diembv/ESP32C6-Outdoor-Tracker/hardware/case/stl/tracker_full_print_plate.stl

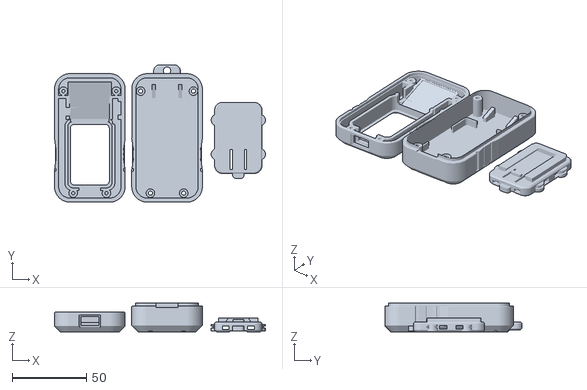
[picture p2: CAD file, 2026-11-12]
hardware/case/stl/tracker_full_print_plate.stl
142.1 x 92.5 x 19.3
