diembv/ESP32C6-Outdoor-Tracker/hardware/case/stl/tracker_bottom_shell.stl

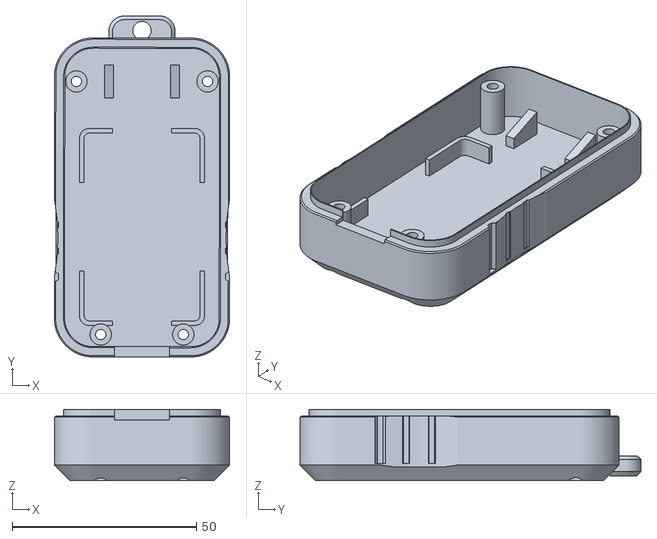
[picture p3: CAD file, 2026-11-12]
hardware/case/stl/tracker_bottom_shell.stl
47.6 x 92.5 x 19.3
