diembv/ESP32C6-Outdoor-Tracker/hardware/case/stl/tracker_bike_mount_base.stl

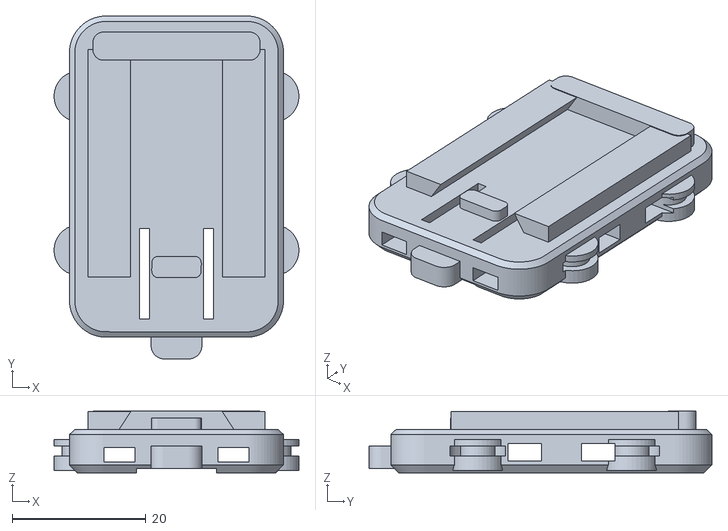
[picture p4: CAD file, 2026-11-12]
hardware/case/stl/tracker_bike_mount_base.stl
36.6 x 51.2 x 9.25
