diembv/ESP32C6-Outdoor-Tracker/hardware/case/stl/tracker_top_cover.stl

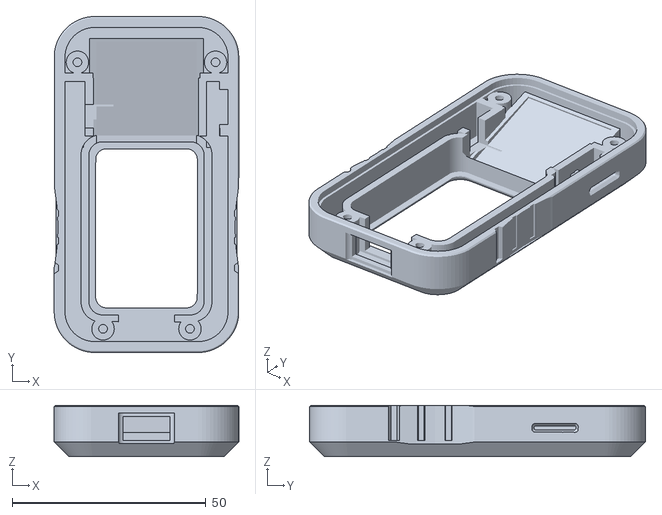
[picture p5: CAD file, 2026-11-12]
hardware/case/stl/tracker_top_cover.stl
47.6 x 86.6 x 13.2
