diembv/ESP32C6-Outdoor-Tracker/(commit log)

2026-09-27 feat: Bring-up GPS, I2C BMP580/IMU, AMOLED display & project setup
2026-09-29 fix SD card for logging
    [main.cpp, sd_logger.cpp, ui_dashboard.cpp]
2026-09-29 add time, fix logging and sd card
    [main.cpp, sd_logger.cpp, sd_logger.h, ui_dashboard.cpp, ui_dashboard.h]
2026-10-01 fix logging, micro SD
    [main.cpp, sd_logger.cpp, sd_logger.h, ui_dashboard.cpp]
2026-10-05 add tool convert gpx and fix
    [main.cpp, sd_logger.cpp, sd_logger.h, ui_dashboard.h]
2026-11-12 chore(hardware): setup standard 3d case directory structure and gitignore
2026-11-12 feat(hardware): integrate 3D case models and generator for Garmin eTrex 32x compact edition
2026-11-14 refactor(phase1): extract core domain (baro_fusion, track_logger), hal_storage, and C6 board descriptor
